zeroping/PoE-STM32F107/armpoe/armpoe.ods

Sheet: Sheet1
Id | Designator | Package | Quantity | Designation | Supplier and ref | Type
62 | X202 | crystal-ABM8 | 1 | CRYSTAL |  | X
10 | U103 | SOT23-5 | 1 | TS431 |  | U
4 | U201 | LQFP64 | 1 | STM32F107XXX-LQFP64 |  | U
6 | U101 | HTSSOP-20 | 1 | PM8803 |  | U
50 | U102 | HMHA281 | 1 | OPTO-TRANSISTOR |  | U
59 | U203 | OS-5 | 1 | MCP1603 |  | U
55 | U202 | SSOP48 | 1 | KSZ8001S |  | U
11 | T102 | HA3691 | 1 | HA3691-AL |  | T
53 | T101 | T1 | 1 | H2019 |  | T
38 | R101,R102 | SM0603 | 2 | BLM18KG101TN1D |  | R
33 | R114 | SM0603 | 1 | 820R |  | R
41 | R109 | SM0603 | 1 | 680R |  | R
44 | R107 | SM0603 | 1 | 60k |  | R
20 | R125 | SM0805 | 1 | 6.78k |  | R
28 | R115 | SM0603 | 1 | 5R6 |  | R
16 | R118 | SM0805 | 1 | 5R6 |  | R
21 | R119 | SM0805 | 1 | 47K |  | R
18 | R123 | SM0805 | 1 | 4.75K |  | R
25 | R104 | SM0805 | 1 | 37R5 |  | R
37 | R103 | SM0603 | 1 | 24.9K |  | R
46 | R111 | SM0603 | 1 | 22R |  | R
17 | R124 | SM0805 | 1 | 21K |  | R
45 | R106 | SM0603 | 1 | 2.7k |  | R
43 | R105 | SM0603 | 1 | 124k |  | R
19 | R122,R120,R117 | SM0805 | 3 | 10R |  | R
23 | R121 | SM0805 | 1 | 10k |  | R
47 | R112 | SM0603 | 1 | 100k |  | R
32 | R110 | SM0603 | 1 | 510 |  | R
57 | R202,R201 | SM0603 | 2 | 220 |  | R
56 | R205,R203,R204,R210 | SM0603 | 4 | 50 |  | R
42 | R113 | SM0603 | 1 | 10 |  | R
15 | R116 | SM1206 | 1 | 0.6 |  | R
54 | R108 | SM0201_r | 1 | 0 |  | R
9 | Q101,Q103,Q102 | Si4848DY-SO8 | 3 | Si4848DY |  | Q
49 | Q104 | Si2325DS_SOT23 | 1 | Si2325DS |  | Q
5 | L102 | LPS4018 | 1 | 1mH |  | L
60 | L201 | LPS4018 | 1 | 10uH |  | L
3 | L101 | MSS7341 | 1 | 10uH |  | L
1 | L103 | SER1360 | 1 | 10uH |  | L
2 | J101 | RJHS-308x | 1 | RJ45 |  | J
61 | JP201 | con-pci_express(pci-e)-PCI-E_4_EDGE | 1 | PCI-E4X_EDGE |  | J
8 | D104,D102,D103,D101,D108,D106,D107,D105 | Diode-SMA_Standard_RevA_26July2010 | 8 | STPS1H100A |  | D
7 | D109 | Diode-SMA_Standard_RevA_26July2010 | 1 | SMAJ58A |  | D
12 | D115,D112,D116,D111,D117,D110,D114,D113 | diode-SOD323-mod | 8 | BAT46J |  | D
14 | C119 | SM1206 | 1 | 47nF |  | C | 200V
48 | C111 | SM0603 | 1 | 470pF |  | C
58 | C209,C215,C216 | SM0603 | 3 | 4.7uF |  | C
52 | C106 | c_elec_10x10.5 | 1 | 33uF |  | C | 100V
51 | C121 | c_elec_8x10.5 | 1 | 330uF |  | C
30 | C123,C114 | SM0603 | 2 | 22nF |  | C
13 | C112 | SM1812 | 1 | 2.2nF 2KV |  | C
29 | C113,C118,C205,C208 | SM0603 | 4 | 1uF |  | C
36 | C101,C110,C103 | SM0603 | 3 | 1uF |  | C | 16V
22 | C108,C107 | SM0805 | 2 | 1uF |  | C | 100V
26 | C117,C115 | SM0603 | 2 | 1nF |  | C
39 | C102 | SM0603 | 1 | 1nF |  | C | 100V
35 | C202,C201 | SM0603 | 2 | 18pF |  | C
27 | C120 | SM0603 | 1 | 10uF |  | C
24 | C122 | SM0805 | 1 | 10uF |  | C
31 | C124 | SM0603 | 1 | 100pF |  | C
34 | C109,C116,C125,C204,C203,C206,C207,C210,C212,C213,C214 | SM0603 | 11 | 100nF |  | C
40 | C104,C105 | SM0603 | 2 | 100nF |  | C | 100V

Sheet: Sheet2
Id | Designator | Package | Quantity | Designation | Supplier and ref | Type | supplier | spn | 28.3856
62 | X202 | crystal-ABM8 | 1 | CRYSTAL |  | X | Future | ABM8-25.000MHZ-B2-T#sthash.wSVRejPp.dpuf | 0.99 | 0.99 | x
10 | U103 | SOT23-5 | 1 | TS431 |  | U | avnet | TS431AILT/BKN | 0.325 | 0.325 | x
4 | U201 | LQFP64 | 1 | STM32F107XXX-LQFP64 |  | U | avnet | STM32F107RBT6 | 4.85 | 4.85 | x
6 | U101 | HTSSOP-20 | 1 | PM8803 |  | U | avnet | PM8803 | 2 | 2 | x
50 | U102 | HMHA281 | 1 | OPTO-TRANSISTOR |  | U |  | HMHA281 | 0.451 | 0.451 | x
59 | U203 | OS-5 | 1 | MCP1603 |  | U | Future | MCP1603T-330I/OS | 0.98 | 0.98
55 | U202 | SSOP48 | 1 | KSZ8001SL |  | U | ComponentsDirect | KSZ8001SL | 1.99 | 1.99
11 | T102 | HA3691 | 1 | HA3691-AL |  | T | Coilcraft |  | 3.63 | 3.63
53 | T101 | T1 | 1 | H2019 |  | T |  |  |  | 0 | x
38 | R101,R102 | SM0603 | 2 | BLM18KG101TN1D | 0805 Substituted | R | Mouser | 81-BLM18KG101TN1D | 0.11 | 0.22 | x
33 | R114 | SM0603 | 1 | 820R |  | R |  |  |  | 0 | x
41 | R109 | SM0603 | 1 | 680R |  | R |  |  |  | 0 | x
44 | R107 | SM0603 | 1 | 60k | CH 60.4K | R |  |  |  | 0 | x
20 | R125 | SM0805 | 1 | 6.78k | CH 6.8K, 0603 | R |  |  |  | 0 | x
16 | R118, R115 | SM0805 | 2 | 5R6 | CH 0603 | R |  |  |  | 0 | x
21 | R119 | SM0805 | 1 | 47K |  | R |  |  |  | 0 | x
18 | R123 | SM0805 | 1 | 4.75K |  | R |  |  |  | 0 | x
25 | R104 | SM0805 | 1 | 37R5 |  | R |  |  |  | 0 | x
37 | R103 | SM0603 | 1 | 24.9K |  | R |  |  |  | 0 | x
46 | R111 | SM0603 | 1 | 22R |  | R |  |  |  | 0 | x
17 | R124 | SM0805 | 1 | 21K |  | R |  |  |  | 0 | x
45 | R106 | SM0603 | 1 | 2.7k |  | R |  |  |  | 0 | x
43 | R105 | SM0603 | 1 | 124k |  | R |  |  |  | 0 | x
19 | R122,R120,R117 | SM0805 | 3 | 10R |  | R |  |  |  | 0 | x
23 | R121 | SM0805 | 1 | 10k |  | R |  |  |  | 0 | x
47 | R112 | SM0603 | 1 | 100k |  | R |  |  |  | 0 | x
32 | R110,R202,R201 | SM0603 | 3 | 510 |  | R |  |  |  | 0 | x
56 | R205,R203,R204,R210 | SM0603 | 4 | 50 |  | R |  |  |  | 0 | x
42 | R113 | SM0603 | 1 | 10 |  | R |  |  |  | 0 | x
15 | R116 | SM1206 | 1 | 0.6 |  | R |  |  |  | 0 | x
9 | Q101,Q103,Q102 | Si4848DY-SO8 | 3 | Si4848DY | subs FDS2582 | Q | Mouser | 781-SI4848DY-T1-E3 | 1.17 | 3.51 | x
49 | Q104 | Si2325DS_SOT23 | 1 | Si2325DS |  | Q | Mouser | 781-SI2325DS-GE3 | 1.1 | 1.1 | x
5 | L102 | LPS4018 | 1 | 1mH |  | L | Coilcraft |  | 0.89 | 0.89
60 | L201 | LPS4018 | 1 | 10uH |  | L | Coilcraft |  | 0.89 | 0.89
3 | L101 | MSS7341 | 1 | 10uH |  | L |  |  | 0.94 | 0.94
1 | L103 | SER1360 | 1 | 10uH |  | L |  |  | 1.22 | 1.22
2 | J101 | RJHS-308x | 1 | RJ45 |  | J | Arrow |  | 0.43 | 0.43 | ?
8 | D104,D102,D103,D101,D108,D106,D107,D105 | Diode-SMA_Standard_RevA_26July2010 | 8 | STPS1H100A |  | D |  |  | 0.172 | 1.376 | x
7 | D109 | Diode-SMA_Standard_RevA_26July2010 | 1 | SMAJ58A |  | D |  |  | 0.1216 | 0.1216 | x
12 | D115,D112,D116,D111,D117,D110,D114,D113 | diode-SOD323-mod | 8 | BAT46J |  | D |  |  | 0.309 | 2.472 | x
14 | C109 | SM1206 | 1 | 47nF |  | C | 200V |  |  | 0 | x
48 | C111 | SM0603 | 1 | 470pF |  | C |  |  |  | 0 | x
58 | C209,C215,C216 | SM0603 | 3 | 4.7uF |  | C |  |  |  | 0 | x
52 | C106 | c_elec_10x10.5 | 1 | 33uF |  | C | 100V |  |  | 0 | x
51 | C121 | c_elec_8x10.5 | 1 | 330uF |  | C |  |  |  | 0 | x
30 | C123,C114 | SM0603 | 2 | 22nF |  | C |  |  |  | 0 | x
13 | C112 | SM1812 | 1 | 2.2nF 2KV |  | C |  |  |  | 0 | x
36 | C101,C110,C103,C113,C118,C205,C208 | SM0603 | 7 | 1uF |  | C | 16V |  |  | 0 | x
22 | C108,C107 | SM0805 | 2 | 1uF | CH1210 | C | 100V |  |  | 0 | x
39 | C102,C117,C115 | SM0603 | 3 | 1nF |  | C | 100V |  |  | 0 | x
35 | C202,C201 | SM0603 | 2 | 18pF |  | C |  |  |  | 0 | x
24 | C122, C120 | SM0805 | 2 | 10uF |  | C |  |  |  | 0 | x
31 | C124 | SM0603 | 1 | 100pF |  | C |  |  |  | 0 | x
34 | C109,C116,C125,C204,C203,C206,C207,C210,C212,C213,C214,C104,C105 | SM0603 | 13 | 100nF |  | C | 100V |  |  | 0 | x
