zeroping/PoE-STM32F107/adapterBreadboard/adapterBreadboard.kicad_pcb

## KiCad design adapterBreadboard/adapterBreadboard.kicad_pcb (2014-05-16)

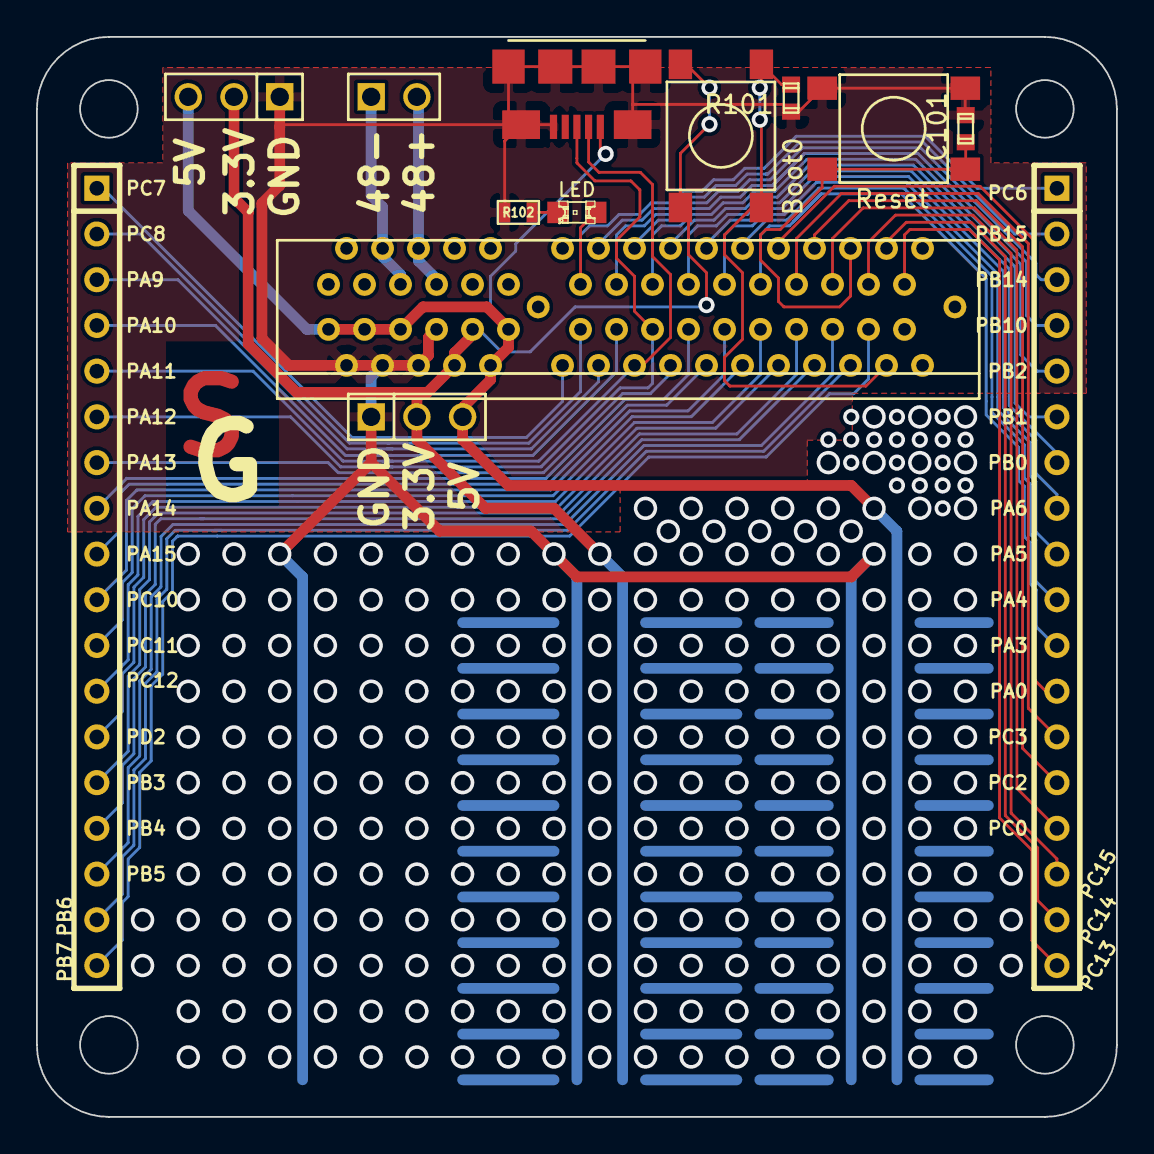
[picture p1: board adapterBreadboard.kicad_pcb from above]

Board: 2 copper layers, 60.0 x 60.0 mm, 13 parts (0 on the bottom side), 44 nets.

Parts:
C101: 0.1uF; c_0603
D101: LED; LED-0805
J101: USB; mincro-usb
JP101: PCI-E4X_EDGE; con-pci_express(pci-e)-PCI-E_64
K101: PWR; PIN_ARRAY_3X1
K102: CONN_3; PIN_ARRAY_3X1
P101, P102: CONN_19; SIL-18
P103: CONN_2; PIN_ARRAY_2X1
R101: 10K; c_0603
R102: 220; SM0603
SW101: Boot0; tact_sw_4.3mm
SW102: Reset; tact_sw_4.3mm

Connections:
+3.3V: JP101.B8, JP101.B9, K101.2, K102.2, SW101.2
+5V: J101.1, JP101.B1, JP101.B3, JP101.B5, JP101.B10, JP101.B11, K101.3, K102.3
/+48V U +: JP101.A6, JP101.A7, P103.2
/+48V U Return: JP101.A4, JP101.A5, P103.1
/BOOT0: JP101.B30, R101.1, SW101.1
/PA0: JP101.A24, P101.12
/PA3: JP101.A23, P101.11
/PA4: JP101.A22, P101.10
/PA5: JP101.A21, P101.9
/PA6: JP101.A20, P101.8
/PA9: JP101.B14, P102.3
/PA10: JP101.B15, P102.4
/PA11: J101.2, JP101.B16, P102.5
/PA12: J101.3, JP101.B17, P102.6
/PA13: JP101.B18, P102.7
/PA14: JP101.B19, P102.8
/PA15: JP101.B20, P102.9
/PB0: JP101.A19, P101.7
/PB1: JP101.A18, P101.6
/PB2: JP101.A17, P101.5
/PB3: JP101.B25, P102.14
/PB4: JP101.B26, P102.15
/PB5: JP101.B27, P102.16
/PB6: JP101.B28, P102.17
/PB7: JP101.B29, P102.18
/PB10: JP101.A16, P101.4
/PB14: JP101.A15, P101.3
/PB15: JP101.A14, P101.2
/PC0: JP101.A27, P101.15
/PC2: JP101.A26, P101.14
/PC3: JP101.A25, P101.13
/PC6: D101.1, JP101.A13, P101.1
/PC7: JP101.B12, P102.1
/PC8: JP101.B13, P102.2
/PC10: JP101.B21, P102.10
/PC11: JP101.B22, P102.11
/PC12: JP101.B23, P102.12
/PC13: JP101.A31, P101.18
/PC14: JP101.A30, P101.17
/PC15: JP101.A29, P101.16
/PD2: JP101.B24, P102.13
/RESET: C101.1, JP101.A28, SW102.1
GND: C101.2, J101.4, J101.5, J101.6, JP101.B2, JP101.B4, JP101.B6, JP101.B7, K101.1, K102.1, R101.2, R102.2, SW102.2
unnamed: D101.2, R102.1
