zeroping/PoE-STM32F107/armpoe/armpoe.kicad_pcb

## KiCad design armpoe/armpoe.kicad_pcb (2014-05-15)

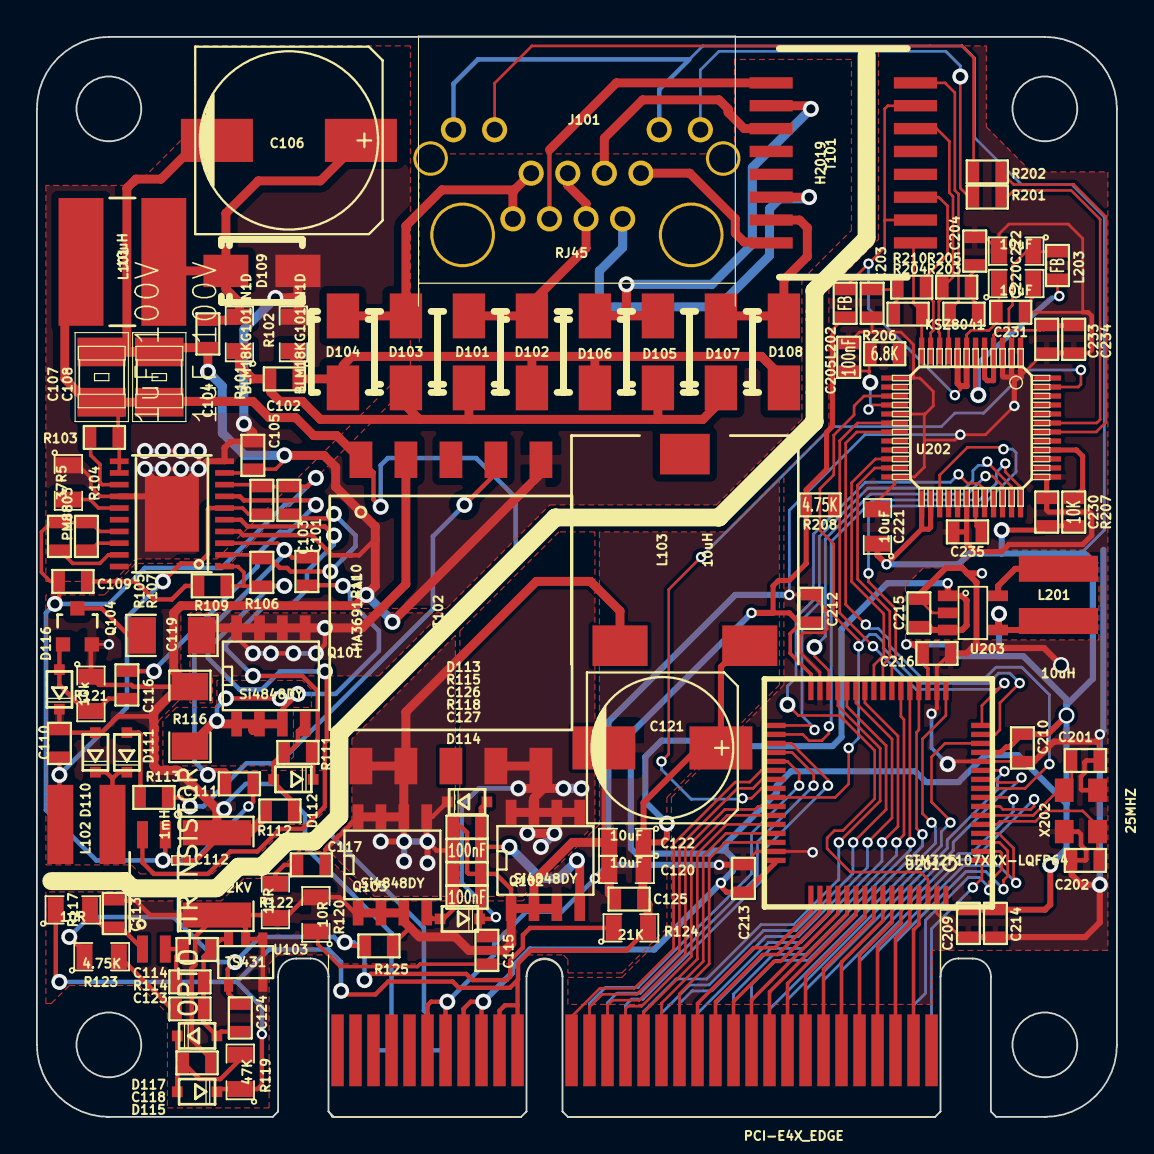
[picture p2: board armpoe.kicad_pcb from above]

Board: 2 copper layers, 60.0 x 60.0 mm, 119 parts (0 on the bottom side), 119 nets.

Parts:
C101, C103, C110: 1uF 16V; SM0603
C102: 1nF 100V; SM0603
C104, C105: 100nF 100V; SM0603
C106: 33uF 100V; c_elec_10x10.5
C107, C108: 1uF 100V; -C1210
C109, C116, C125, C126, C127, C203, C204, C205, C210, C212, C213, C214, C230, C231, C233, C234, C235: 100nF; SM0603
C111: 470pF; SM0603
C112: 2.2nF 2KV; SM1812
C113, C118: 1uF; SM0603
C114, C123: 22nF; SM0603
C115, C117: 1nF; SM0603
C119: 47nF 200V; SM1206
C120, C122, C220, C221, C222: 10uF; SM0805
C121: 330uF; c_elec_8x10.5
C124: 100pF; SM0603
C201, C202: 18pF; SM0603
C209, C215, C216: 4.7uF; SM0603
D101, D102, D103, D104, D105, D106, D107, D108: STPS1H100A; Diode-SMA_Standard_RevA_26July2010
D109: SMAJ58A; Diode-SMA_Standard_RevA_26July2010
D110, D111, D112, D113, D114, D115, D116, D117: BAT46J; diode-SOD323-mod
J101: RJ45; RJHS-308x
JP201: PCI-E4X_EDGE; con-pci_express(pci-e)-PCI-E_4_EDGE
L101: 10uH; MSS7341
L102: 1mH; LPS4018
L103: 10uH; SER1360
L201: 10uH; LPS4018
L202, L203: FB; SM0603
Q101, Q102, Q103: Si4848DY; Si4848DY-SO8
Q104: Si2325DS; Si2325DS_SOT23
R101, R102: BLM18KG101TN1D; SM0805
R103: 24.9K; SM0603
R104: 37R5; SM0805
R105: 124k; SM0603
R106: 2.7k; SM0603
R107: 60k; SM0603
R108: 0; SM0201_r
R109: 680R; SM0603
R110, R201, R202: 510; SM0603
R111: 22R; SM0603
R112: 100k; SM0603
R113: 10; SM0603
R114: 820R; SM0603
R115, R118: 100K; SM0603
R116: 0.15; SM1206
R117, R120, R122: 10R; SM0805
R119: 47K; SM0805
R121: 10k; SM0805
R123: 4.75K; SM0805
R124: 21K; SM0805
R125, R206: 6.8K; SM0603
R203, R204, R205, R210: 50; SM0603
R207: 10K; SM0603
R208: 4.75K; SM0603
T101: H2019; T1
T102: HA3691-AL; HA3691
U101: PM8803; HTSSOP-20
U102: OPTO-TRANSISTOR; HMHA281
U103: TS431; SOT23-5
U201: STM32F107XXX-LQFP64; LQFP64
U202: KSZ8041; -TQFP48
U203: MCP1603; OS-5
X202: 25MHZ; crystal-ABM8

Connections:
+1.8V: C222.1, C233.1, C234.1, L203.1, U202.4, U202.5
+3.3V: C209.1, C210.1, C212.1, C213.1, C214.1, C216.1, C221.1, C230.1, J101.10, J101.12, JP201.B8, JP201.B9, L201.2, L202.1, R207.1, R208.1, U201.13, U201.19, U201.32, U201.48, U201.64, U202.25, U202.26, U203.4
+5V: C120.1, C121.1, C122.1, C125.1, C215.1, D115.2, JP201.B10, JP201.B11, L103.2, R117.1, R119.1, R124.2, U203.1, U203.3
/48V+ unfiltered input: C104.1, C106.1, D109.2, L101.1, R101.2
/ARTN: C101.2, C103.2, C109.1, C111.2, R105.2, R107.2, R108.2, U101.8, U101.17, U102.4
/CURRENT_SENSE: C111.1, R110.1, U101.3
/DELAY_SET: R107.1, U101.18
/FREQ_SET: R105.1, U101.19
/GAT1: D112.2, R111.1, U101.5
/GAT2: C116.1, U101.7
/MCU/A13: JP201.A13, U201.37
/MCU/A14: JP201.A14, U201.36
/MCU/A15: JP201.A15, U201.35
/MCU/A16: JP201.A16, U201.29
/MCU/A17: JP201.A17, U201.28
/MCU/A18: JP201.A18, U201.27
/MCU/A19: JP201.A19, U201.26
/MCU/A20: JP201.A20, U201.22
/MCU/A21: JP201.A21, U201.21
/MCU/A22: JP201.A22, U201.20
/MCU/A23: JP201.A23, U201.17
/MCU/A24: JP201.A24, U201.14
/MCU/A25: JP201.A25, U201.11
/MCU/A26: JP201.A26, U201.10
/MCU/A27: JP201.A27, U201.8
/MCU/A28: JP201.A28, U201.7
/MCU/A29: JP201.A29, U201.4
/MCU/A30: JP201.A30, U201.3
/MCU/A31: JP201.A31, U201.2
/MCU/A32: JP201.A32, U201.1
/MCU/B12: JP201.B12, U201.38
/MCU/B13: JP201.B13, U201.39
/MCU/B14: JP201.B14, U201.42
/MCU/B15: JP201.B15, U201.43
/MCU/B16: JP201.B16, U201.44
/MCU/B17: JP201.B17, U201.45
/MCU/B18: JP201.B18, U201.46
/MCU/B19: JP201.B19, U201.49
/MCU/B20: JP201.B20, U201.50
/MCU/B21: JP201.B21, U201.51
/MCU/B22: JP201.B22, U201.52
/MCU/B23: JP201.B23, U201.53
/MCU/B24: JP201.B24, U201.54
/MCU/B25: JP201.B25, U201.55
/MCU/B26: JP201.B26, U201.56
/MCU/B27: JP201.B27, U201.57
/MCU/B28: JP201.B28, U201.58
/MCU/B29: JP201.B29, U201.59
/MCU/B30: JP201.B30, U201.60
/MCU/B31: JP201.B31, U201.61
/MCU/ETH_INT: U201.62, U202.32
/MCU/ETH_REXT: C205.1, R206.1, U202.16
/MCU/ETH_RST: U201.40, U202.47
/MCU/LED1: J101.11, R202.2
/MCU/LED2: J101.9, R201.2
/MCU/MCO_25: U201.15, U201.41, U202.15
/MCU/RMII_CRX_DV: U201.23, U202.27
/MCU/RMII_MDC: U201.9, U202.19
/MCU/RMII_MDIO: R208.2, U201.16, U202.18
/MCU/RMII_RX0: U201.24, U202.23
/MCU/RMII_RX1: U201.25, U202.22
/MCU/RMII_TX0: U201.33, U202.35
/MCU/RMII_TX1: U201.34, U202.36
/MCU/RMII_TXEN: U201.30, U202.34
/MCU/RX+: R205.1, T101.6, U202.10
/MCU/RX-: R203.2, T101.8, U202.9
/MCU/RXCT: C220.1, C231.1, L202.2, T101.2, T101.7, U202.7, U202.8
/MCU/TX+: R204.2, T101.1, U202.12
/MCU/TX-: R210.2, T101.3, U202.11
/MCU/Unisolated 48 +: C107.1, C108.1, JP201.A6, JP201.A7, L101.2, R103.1, T102.1, U101.11, U101.12
/MCU/Unisolated 48 -: C104.2, C105.1, C106.2, C107.2, C108.2, C110.2, C112.1, D110.1, D116.2, JP201.A3, JP201.A4, Q104.S, R108.1, R112.1, R116.2, R121.1, T102.5, U101.4, U101.9
/PM8803_5V_REG: C101.1, R106.1, U101.2
/PM8803_8V_REG: C103.1, C110.1, L102.1, U101.6
/PWM_CTL: R106.2, R109.2, U101.1, U102.5
/VSS input: C105.2, D109.1, R102.2, R104.1, U101.10, U101.14, U101.PAD
/activeGate1: C126.2, D113.1, Q102.G, R115.2
/activeGate2: C127.2, D114.1, Q103.G, R118.1
/conv_out_1: C117.1, C126.1, D113.2, L103.1, Q103.D, T102.9, T102.10
/conv_out_2: C115.1, C127.1, D114.2, Q102.D, T102.6, T102.7
/primary low: C119.1, Q101.D, T102.2
GND: C112.2, C113.1, C118.1, C120.2, C121.2, C122.2, C125.2, C201.1, C202.2, C203.2, C204.1, C205.2, C209.2, C210.2, C212.2, C213.2, C214.2, C215.2, C216.2, C220.2, C221.2, C222.2, C230.2, C231.2, C233.2, C234.2, C235.2, JP201.B6, JP201.B7, Q102.S, Q103.S, R115.1, R118.2, R120.2, R122.2, R125.1, R206.2, U103.1, U103.2, U103.5, U201.12, U201.18, U201.31, U201.47, U201.63, U202.1, U202.2, U202.3, U202.13, U202.17, U202.24, U202.30, U202.37, U203.2, X202.3
unnamed: Q101.S, R110.2, R116.1
unnamed: D112.1, Q101.G, R111.2, R112.2
unnamed: C116.2, D116.1, Q104.G, R121.2
unnamed: R104.2, U101.15
unnamed: R103.2, U101.13
unnamed: R113.2, T102.4
unnamed: C117.2, R122.1
unnamed: C118.2, D115.1, D117.2, R119.2
unnamed: C114.1, R114.2, U102.2
unnamed: C109.2, R109.1
unnamed: C113.2, R117.2, U102.1
unnamed: D110.2, D111.2, L102.2
unnamed: D111.1, R113.1
unnamed: J101.2, T101.14
unnamed: D101.1, D102.2, J101.4, J101.5
unnamed: J101.6, T101.9
unnamed: D103.1, D104.2, J101.7, J101.8
unnamed: C102.1, D101.2, D103.2, D105.2, D107.2, R101.1
unnamed: C102.2, D102.1, D104.1, D106.1, D108.1, R102.1
unnamed: J101.3, T101.11
unnamed: D107.1, D108.2, T101.15
unnamed: J101.1, T101.16
unnamed: C114.2, C123.1, C124.1, D117.1, R114.1, U103.3
unnamed: C123.2, R123.2
unnamed: C124.2, R123.1, R124.1, R125.2, U103.4
unnamed: D105.1, D106.2, T101.10
unnamed: C119.2, Q104.D
unnamed: C115.2, R120.1
unnamed: R202.1, U202.42
unnamed: C203.1, R204.1, R210.1
unnamed: R201.1, U202.43
unnamed: R207.2, U202.40
unnamed: C235.1, U202.31
unnamed: C202.1, U201.5, X202.1
unnamed: C201.2, U201.6, X202.2
unnamed: L203.2, U202.6
unnamed: L201.1, U203.5
unnamed: C204.2, R203.1, R205.2
