zeroping/PoE-STM32F107/(commit log)

2013-09-29 initial checkin
    [MCU.sch, armpoe.kicad_pcb, armpoe.sch]
2013-10-01 looks to be a complete board, pending a check with the BOM and a good look-over
    [MCU.sch, armpoe.kicad_pcb, armpoe.sch]
2013-10-04 swapped passives to match what I can order.
    [MCU.sch, armpoe.kicad_pcb, armpoe.sch]
2013-10-09 All routed. Again.
    [MCU.sch, armpoe.kicad_pcb, armpoe.sch]
2014-01-30 This is what was sent off, I belive. I'm in the process fo fixing the errors now
    [armpoe-B_Cu.gbl, armpoe-B_Mask.gbs, armpoe-B_SilkS.gbo, armpoe-Edge_Cuts.gbr, armpoe-F_Cu.gtl, armpoe-F_Mask.gts, armpoe-F_SilkS.gto, armpoe.drl]
2014-01-30 fixed pci express card slot size
    [armpoe.kicad_pcb]
2014-02-12 most of the fixes form V1. looking to change pinout.
    [MCU.sch, armpoe.kicad_pcb, armpoe.ods, armpoe.sch]
2014-02-12 got everything rerouted, still haven't changed pinout. Still need to route int line.
    [MCU.sch, armpoe.kicad_pcb, armpoe.sch]
2014-05-15 looks done, except the connector needs to be moved over (which will suck)
    [armpoe.kicad_pcb, armpoe.sch]
2014-05-15 Moved connector. Mostly finished.
    [adapterBreadboard.kicad_pcb, adapterBreadboard.sch]
2014-05-16 As ordered the first time, but with a fix for the resistor
    [adapterBreadboard-B_Cu.gbl, adapterBreadboard-B_Mask.gbs, adapterBreadboard-B_SilkS.gbo, adapterBreadboard-Edge_Cuts.gbr, adapterBreadboard-F_Cu.gtl, adapterBreadboard-F_Mask.gts, adapterBreadboard-F_SilkS.gto, adapterBreadboard.drl]
2014-07-11 Not sure what changed -old commit
    [MCU.sch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]
